hotchk155/MIDI-Hub/img/14.jpg

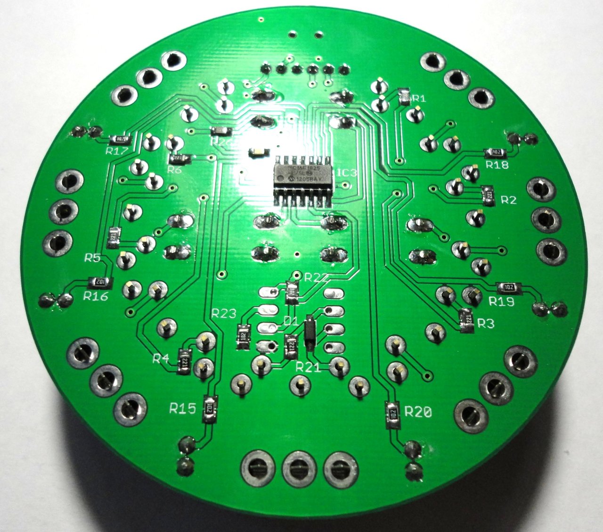
img/14.jpg
