hotchk155/MIDI-Hub/img/05.jpg

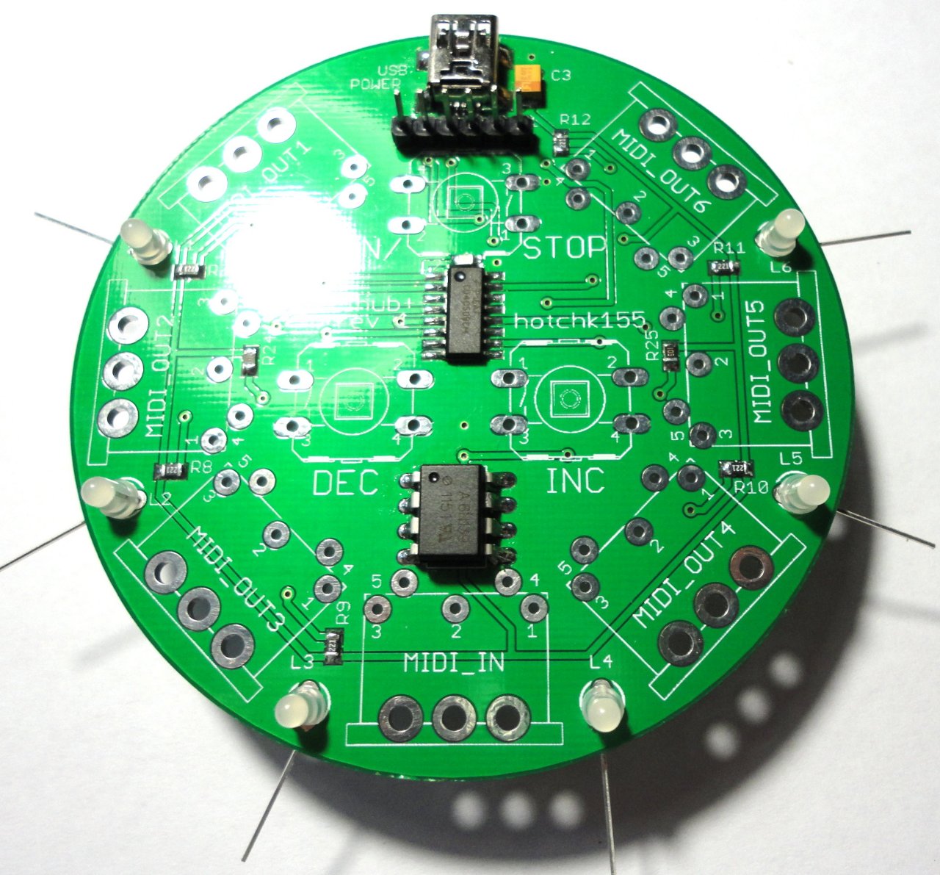
img/05.jpg
