hotchk155/MIDI-Hub/README

PIC based 6-port MIDI hub with onboard beat clock
Check the project WIKI on GITHUB for more info
