hotchk155/MIDI-Hub/hardware/board.png

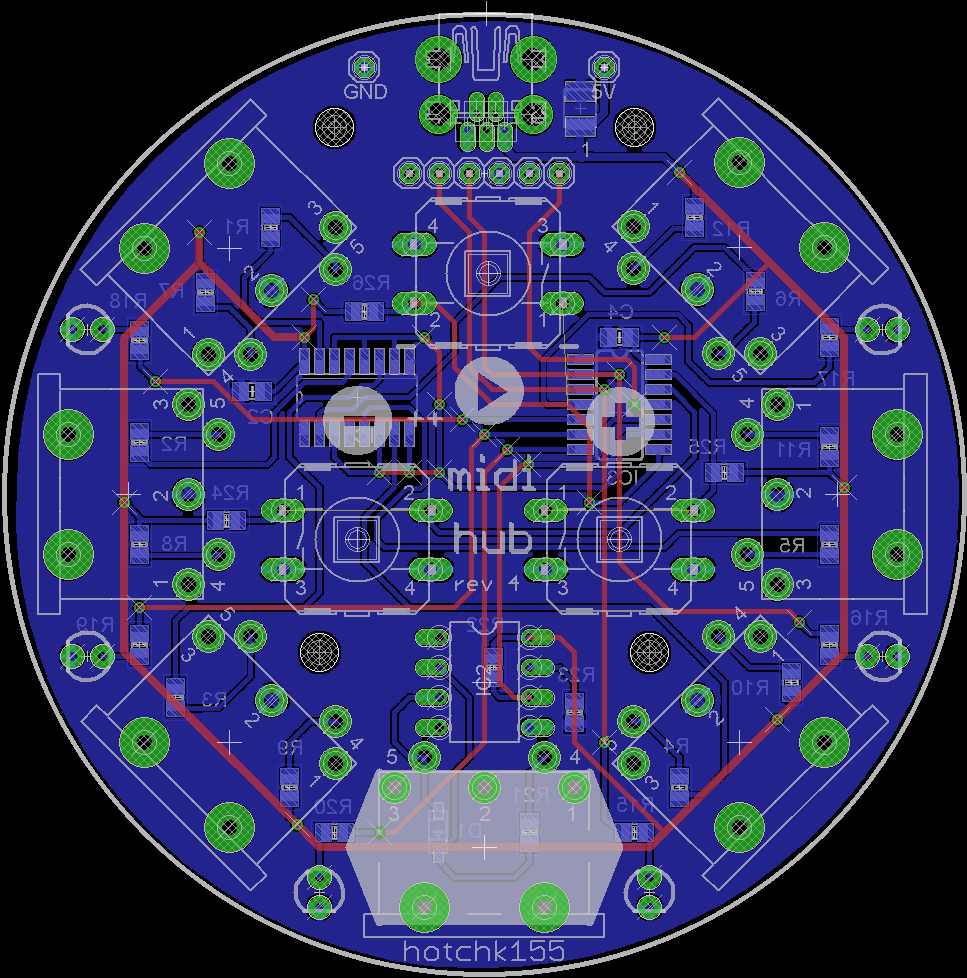
hardware/board.png
