hotchk155/MIDI-Hub/hardware/minus.bmp

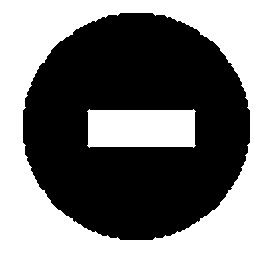
hardware/minus.bmp
