hotchk155/MIDI-Hub/hardware/pause.bmp

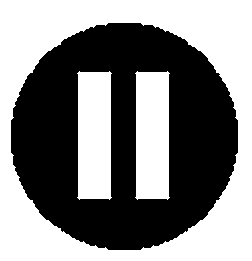
hardware/pause.bmp
