hotchk155/MIDI-Hub/hardware/play.bmp

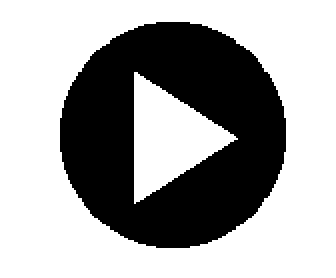
hardware/play.bmp
