hotchk155/MIDI-Hub/hardware/plus.bmp

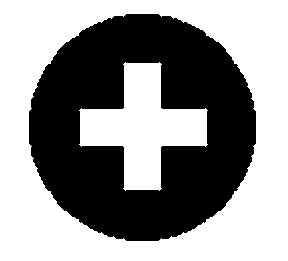
hardware/plus.bmp
