hotchk155/MIDI-Hub/hardware/schem.png

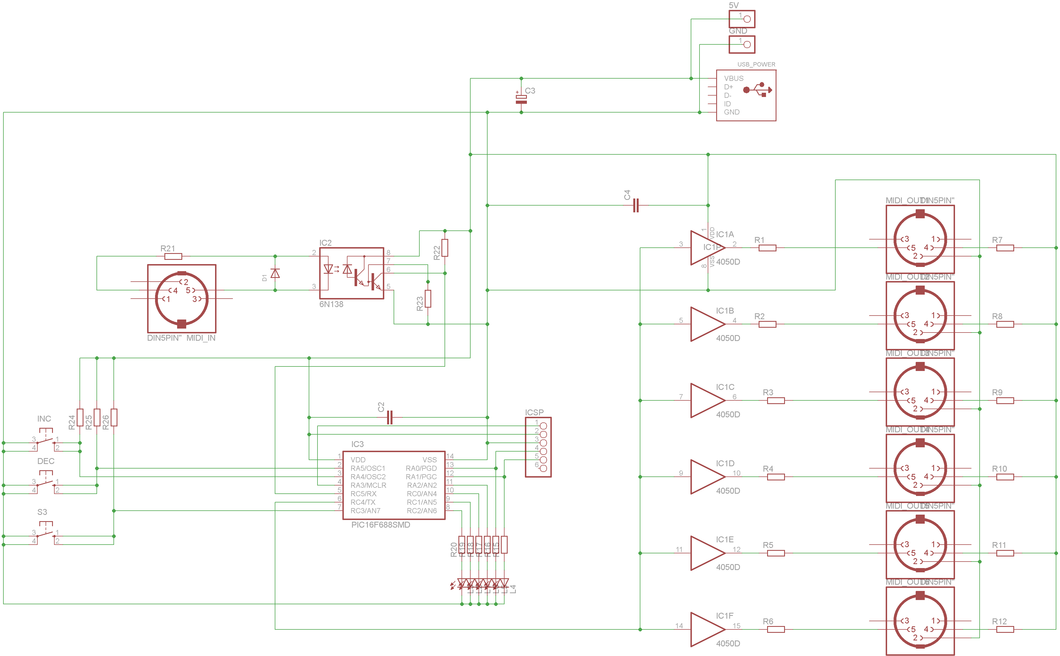
hardware/schem.png
