hotchk155/MIDI-Hub/img/01.jpg

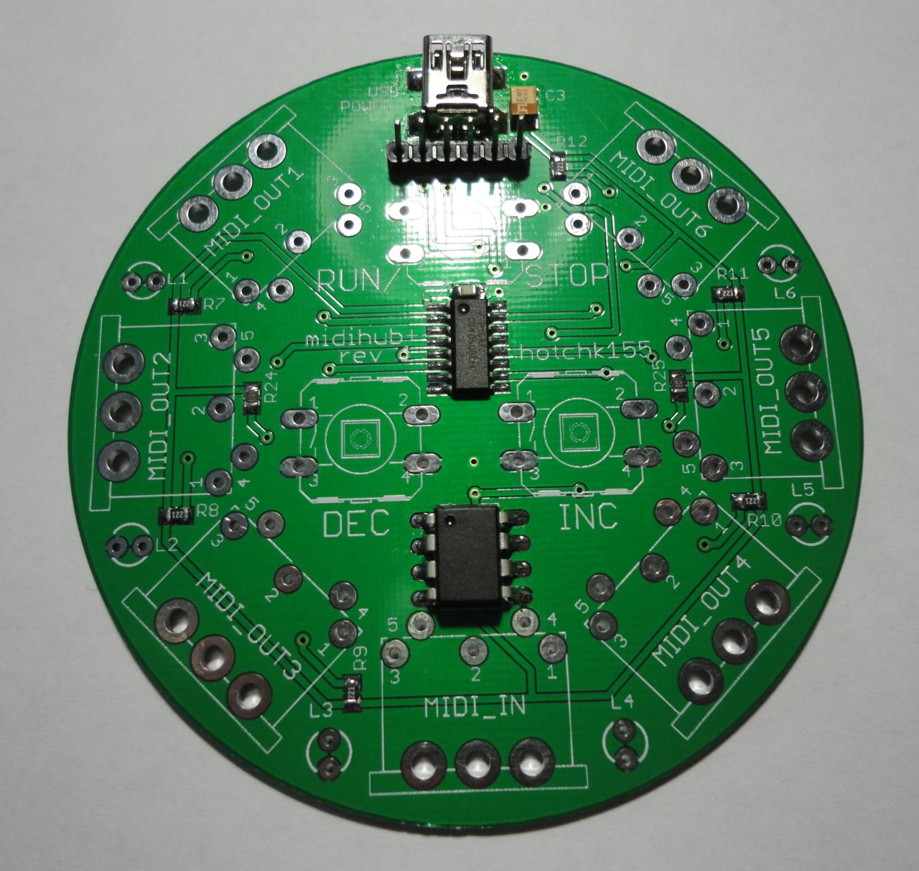
img/01.jpg
