hotchk155/MIDI-Hub/img/02.jpg

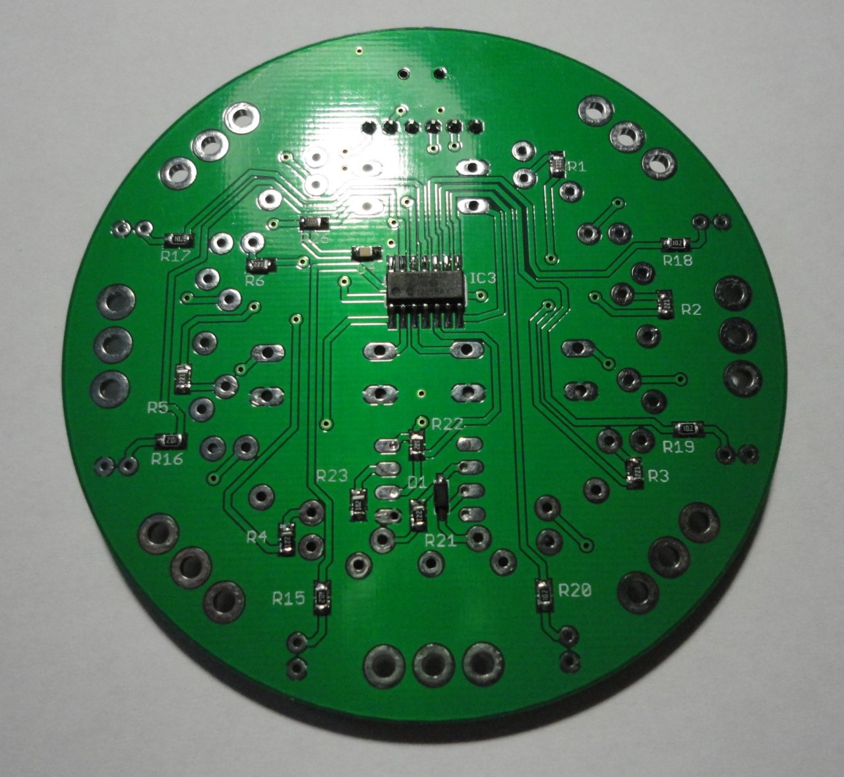
img/02.jpg
