hotchk155/MIDI-Hub/img/03.jpg

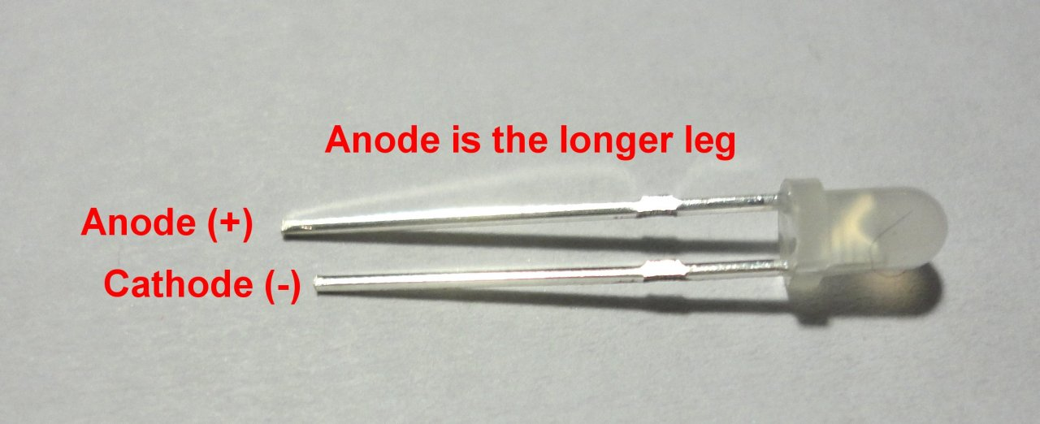
img/03.jpg
