hotchk155/MIDI-Hub/img/04.jpg

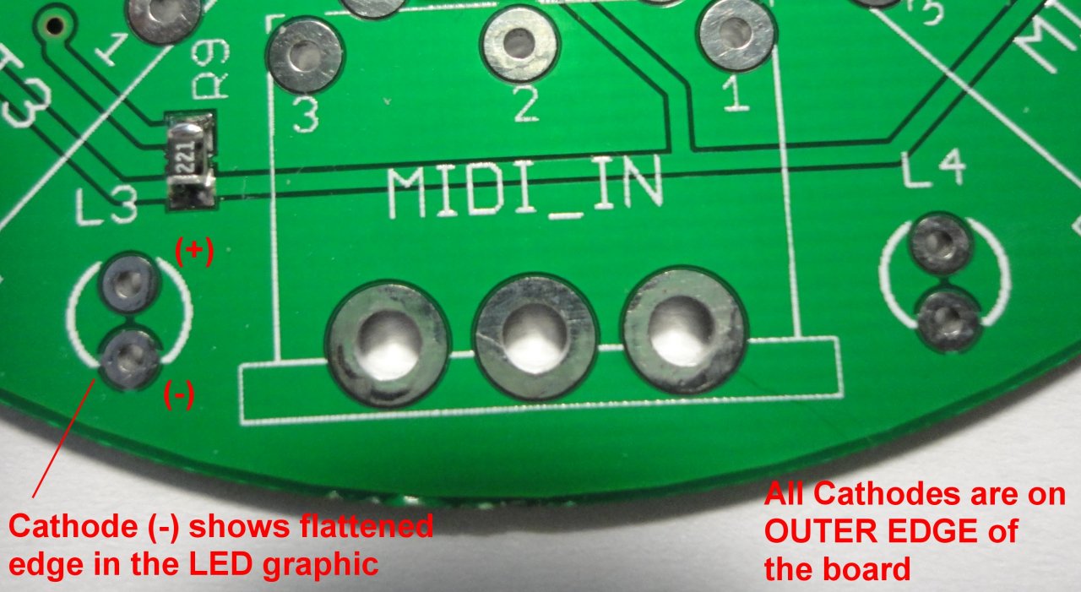
img/04.jpg
