hotchk155/MIDI-Hub/img/06.jpg

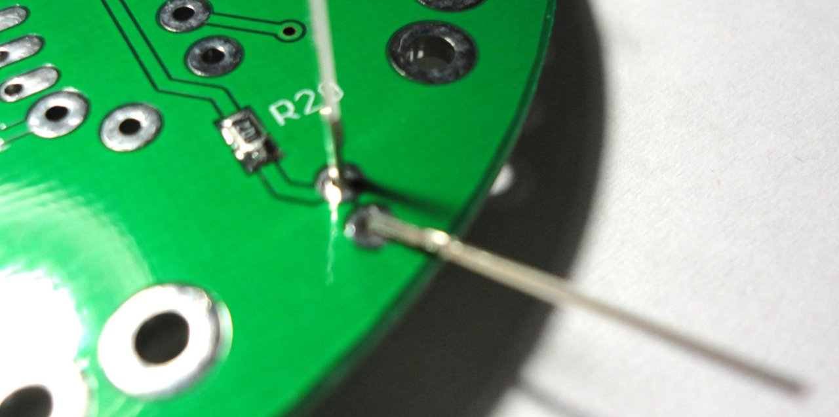
img/06.jpg
