hotchk155/MIDI-Hub/img/07.jpg

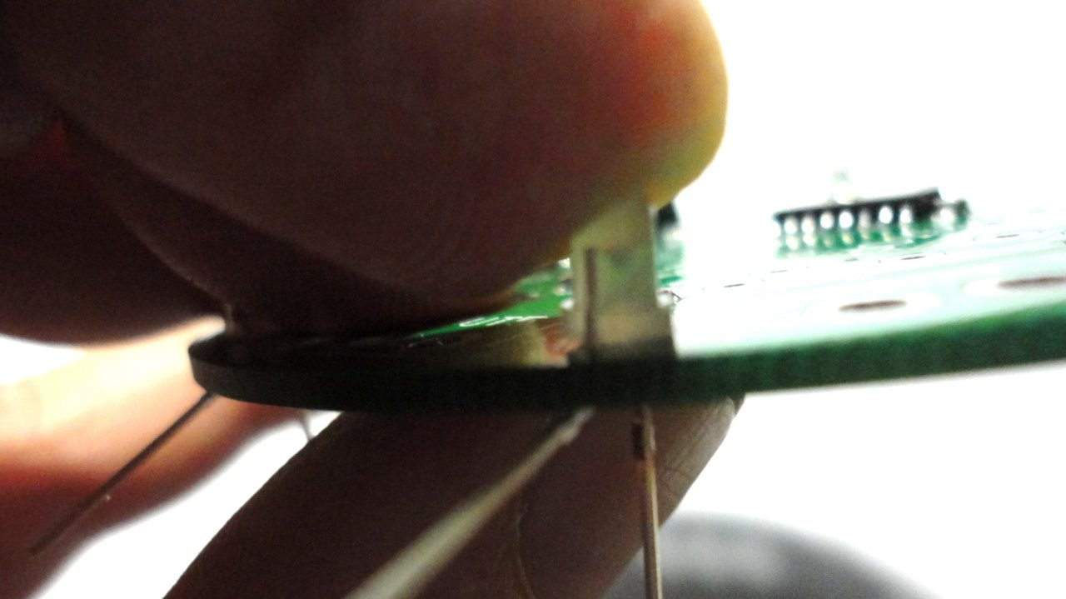
img/07.jpg
