hotchk155/MIDI-Hub/img/08.jpg

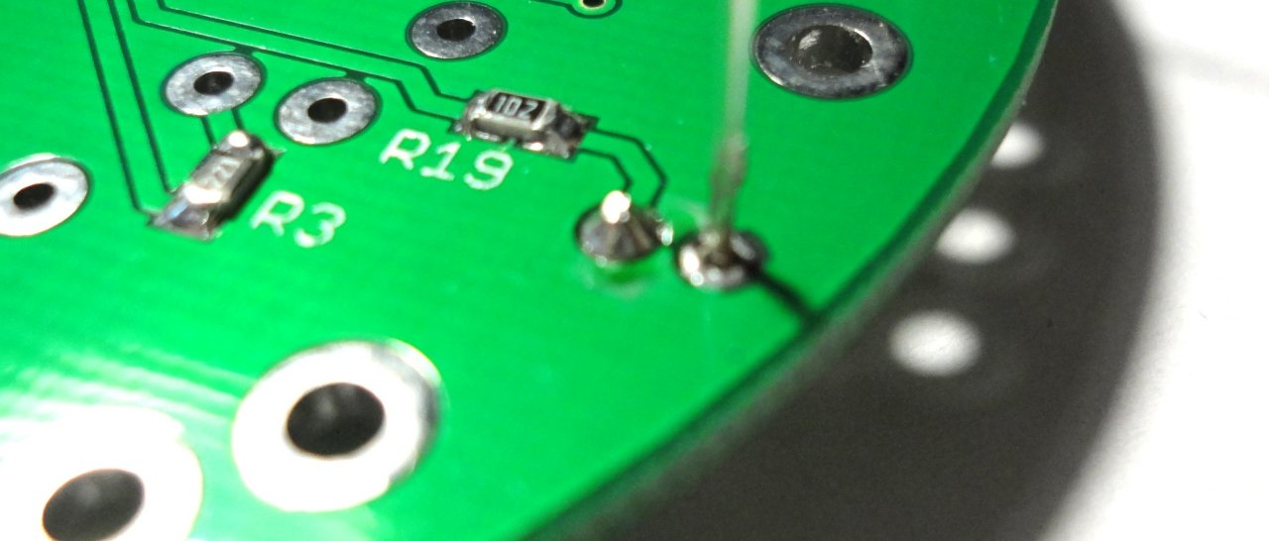
img/08.jpg
