hotchk155/MIDI-Hub/img/09.jpg

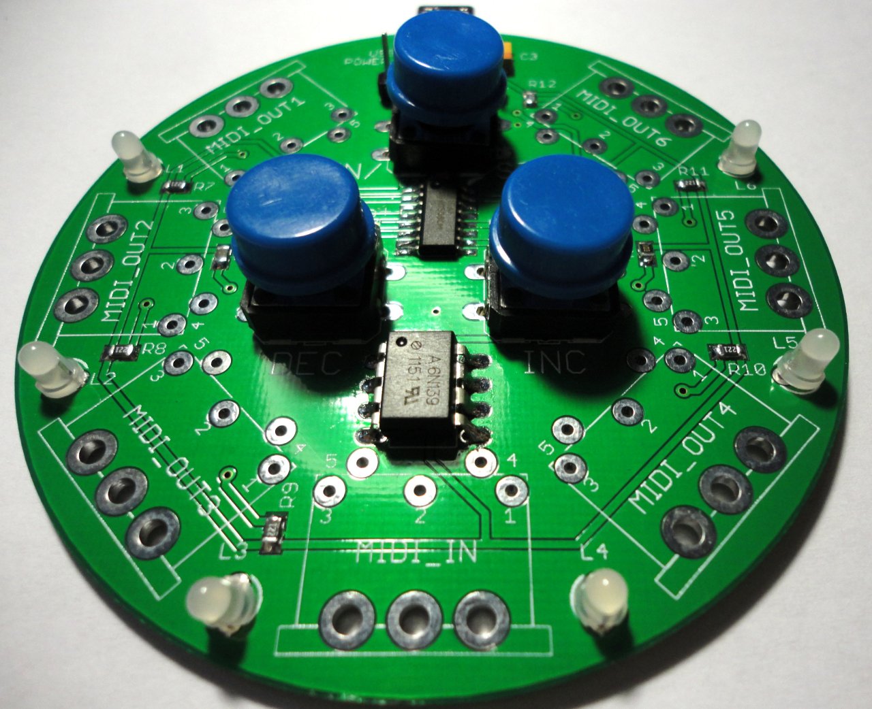
img/09.jpg
