hotchk155/MIDI-Hub/img/10.jpg

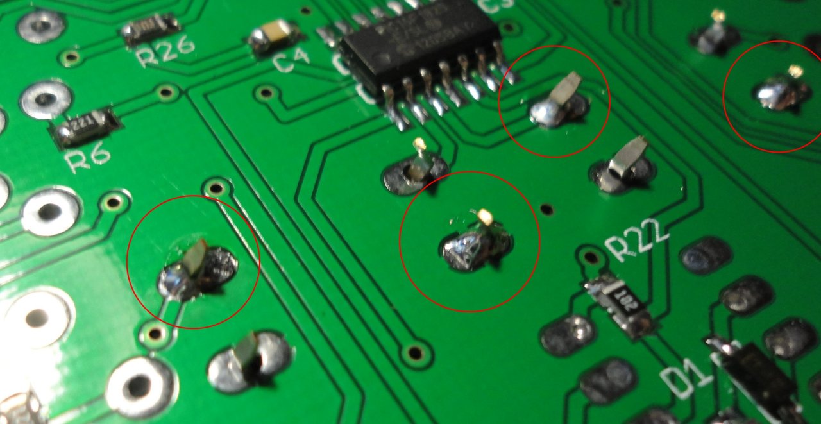
img/10.jpg
