hotchk155/MIDI-Hub/img/11.jpg

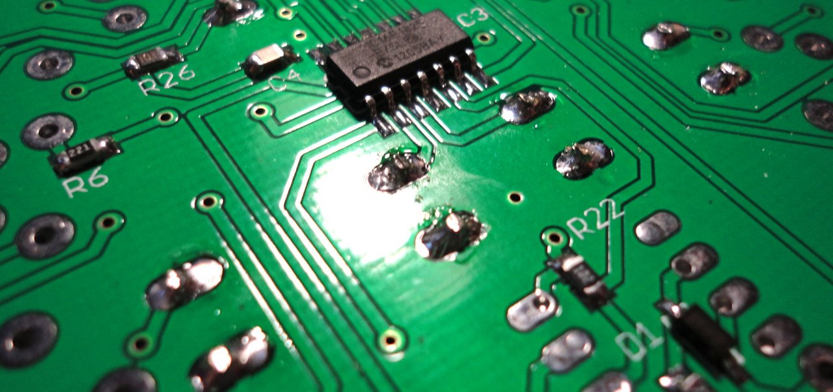
img/11.jpg
