hotchk155/MIDI-Hub/img/12.jpg

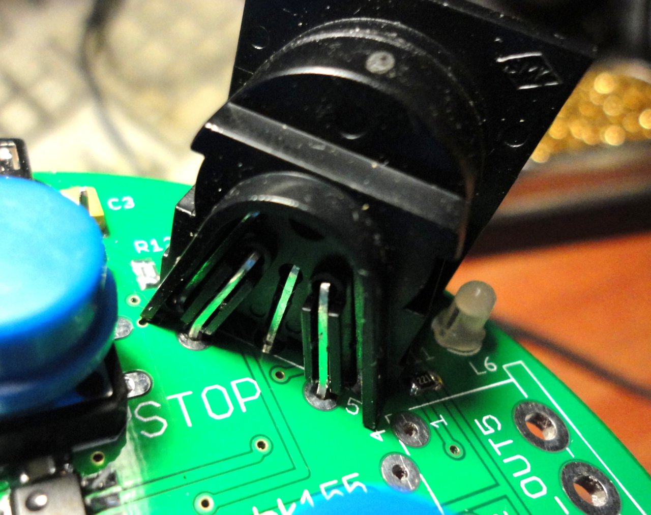
img/12.jpg
