hotchk155/MIDI-Hub/img/13.jpg

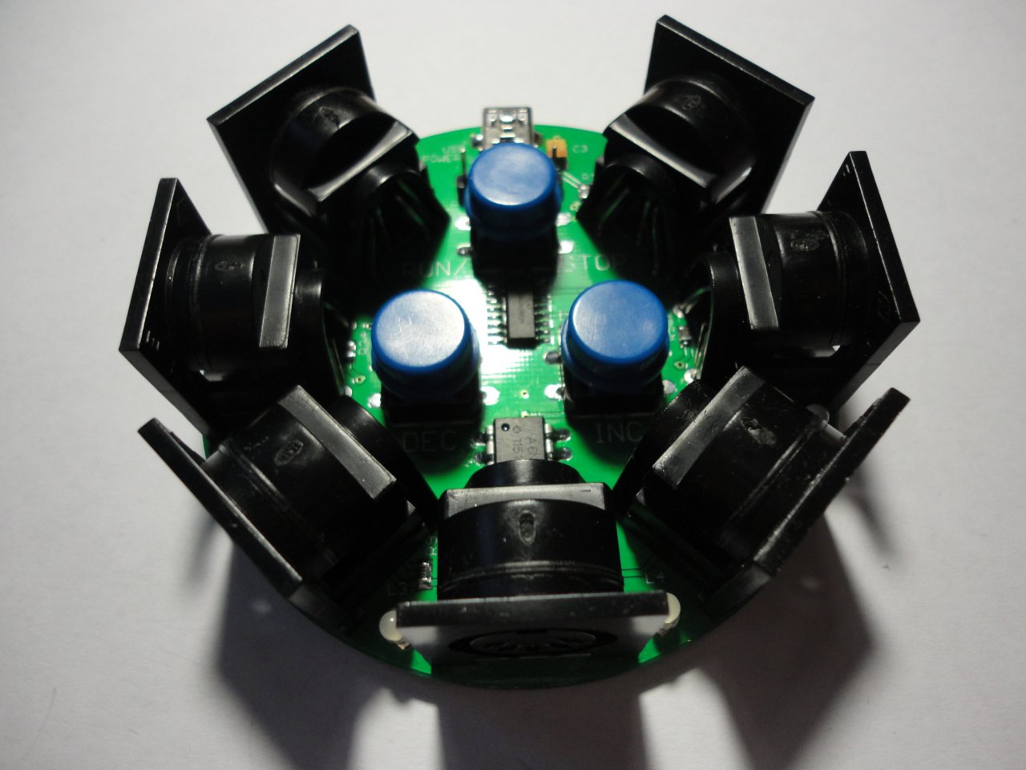
img/13.jpg
