hotchk155/MIDI-Hub/img/15.jpg

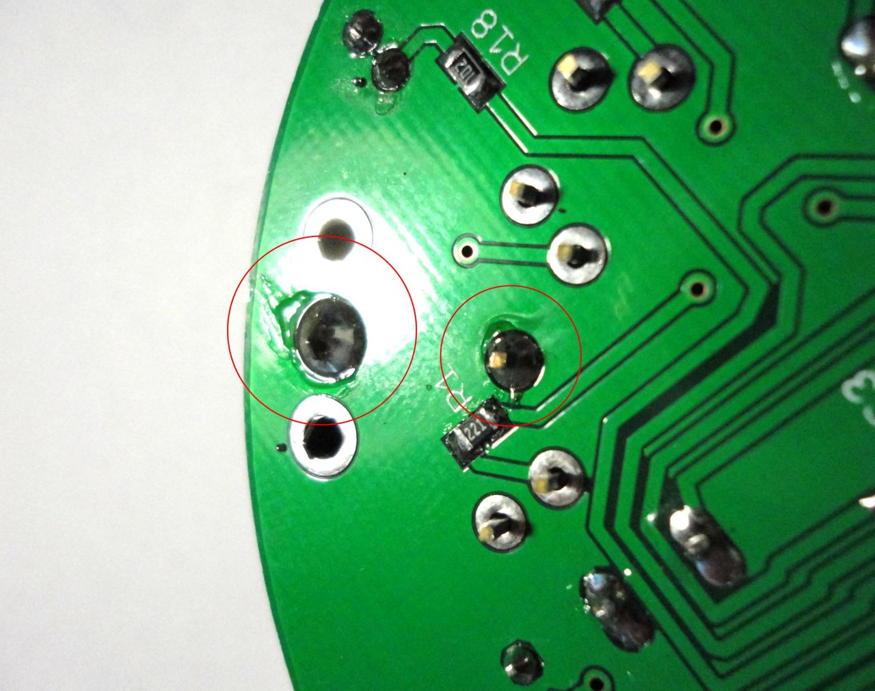
img/15.jpg
