hotchk155/MIDI-Hub/img/16.jpg

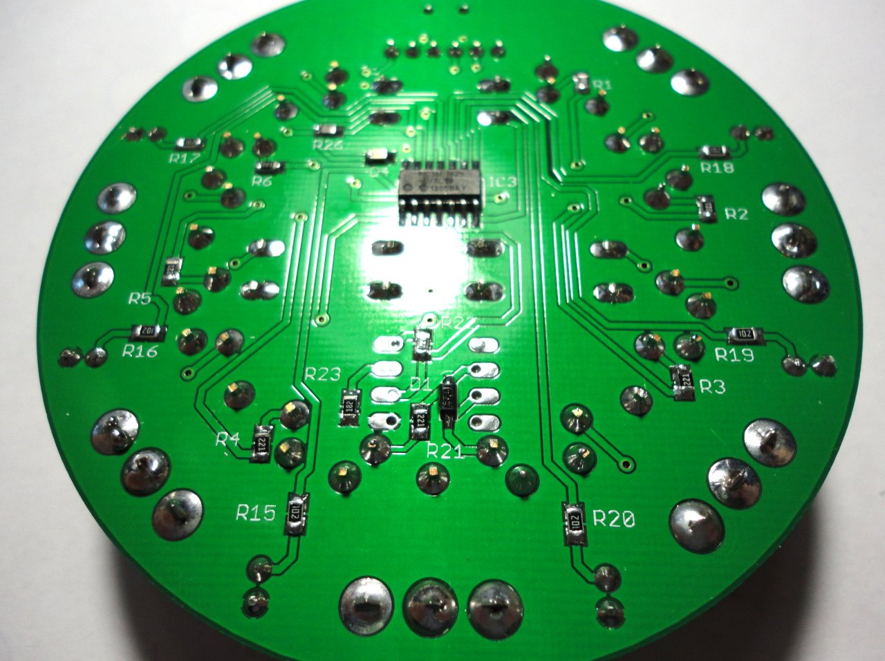
img/16.jpg
