hotchk155/MIDI-Hub/img/17.jpg

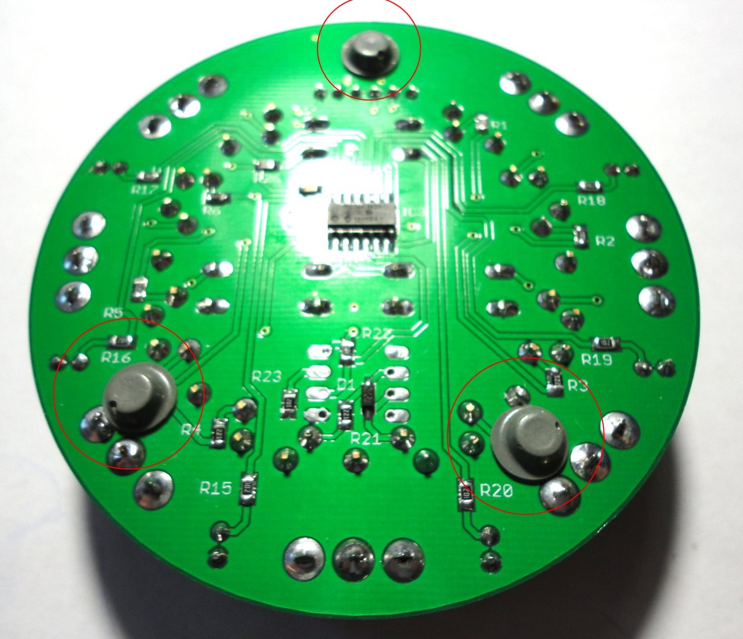
img/17.jpg
