hotchk155/MIDI-Hub/img/18.jpg

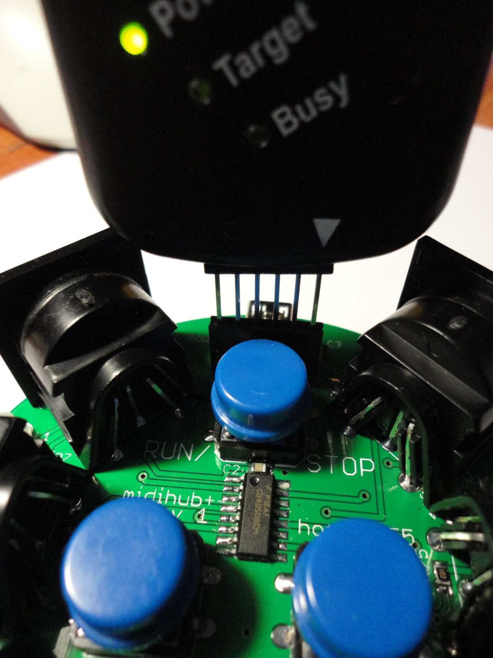
img/18.jpg
