hotchk155/MIDI-Hub/img/KitContents.jpg

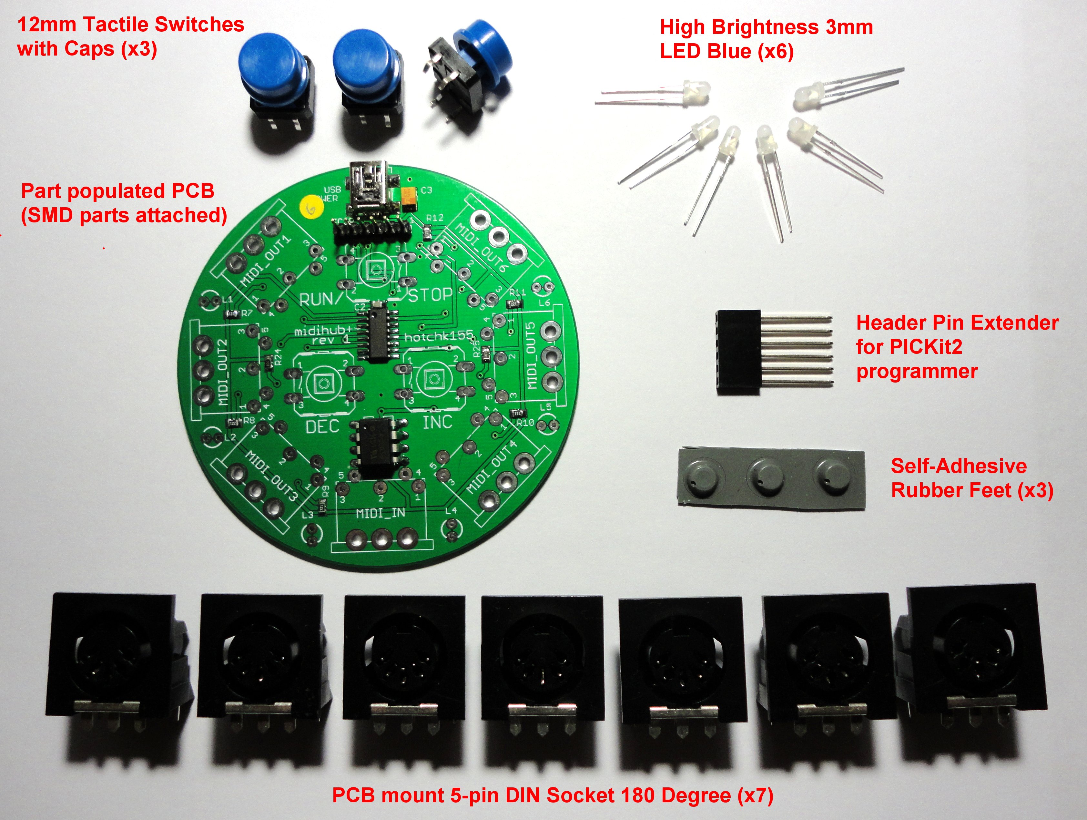
img/KitContents.jpg
