hotchk155/MIDI-Hub/docs/test.docx

Check cap orientation (red stripe down)

Apply USB power

Keyboard to Hub MIDI input

Hub MIDI output 1 to PC input

Play notes on keyboard and use MIDI-OX to check input

Check LEDs beside MIDI input blink with traffic

Press START and check that all LEDs function

Check MIDI clock messages received

Press STOP – START and check for MIDI stop/start

Check 120BPM when running

Press ++ ten times and check 130BPM

Press ++ and -- together and check for 120BPM

Press -- ten times and check 110BPM

Use each MIDI output and check clock messages are passed
