hotchk155/MIDI-Hub/docs/test.odt

All Pin 4's are 220 R to +5V

Blue points 10k to +5V

No short to GND to +5V

Red-Red 1k8

Yellow-Yellow 1k8

Green-Green 220R
