hotchk155/MIDI-Hub/(commit log)

2013-02-03 hardware info
    [midihub.brd, midihub.sch]
2013-03-30 Version 1.01
    Resolve an issue with thru buffer position which can cause thru output
    to be 1 byte behind input
    [MidiHub.c]
2013-06-02 New PCB layout
    [midihub.brd, midihub.sch]
2013-06-27 move all SMDs to reverse of board
    [midihub.brd]
2013-06-27 v3 layout
    [midihub.brd, midihub.sch]
2013-07-12 bom changes
2013-11-17 Changes for version H5
    1) Press and hold PLAY during clock mode to "lock" into run mode.
    Pressing PLAY then sends MIDI START without stopping clock - allows
    resynch of slave devices.
    2) In SPLIT mode MIDI START an be sent by pressing PLAY and
    STOP/CONTINUE by pressing PLUS
2013-12-29 tighter baudrate definition, added version display
    [MidiHub.c]
2014-08-30 working on rev4
    grounded output pins 2
    [midihub.brd, midihub.sch]
2014-08-30 rev4
    adding screw holes for attaching base
    [midihub.brd, midihub.sch]
2014-09-08 rev4 pcb proto run
    [midihub.brd]
